kcfnen1916/wearable_tegaki/case/BASE_revised.stl

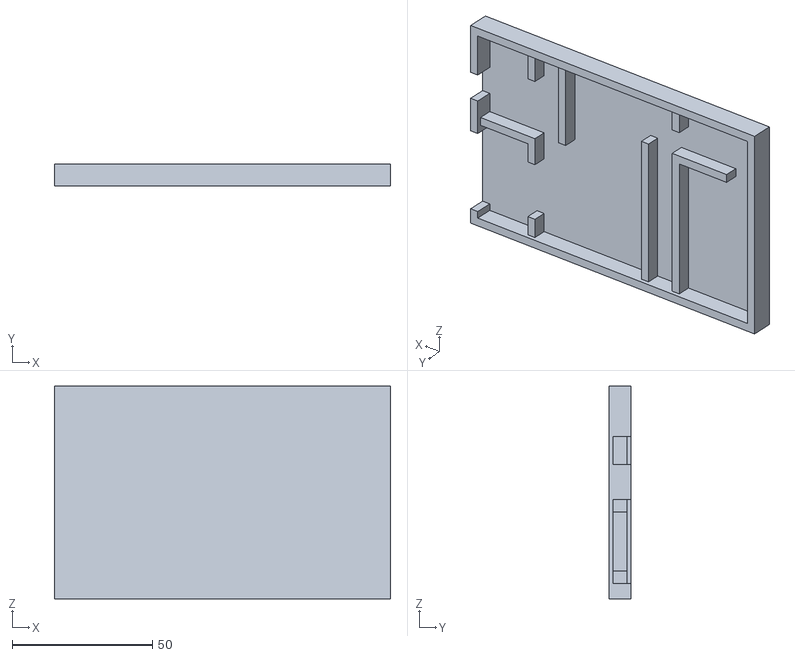
[picture p1: CAD file, 2019-09-17]
case/BASE_revised.stl
120.0 x 8.00 x 76.0
