kcfnen1916/wearable_tegaki/case/COVER_revised.stl

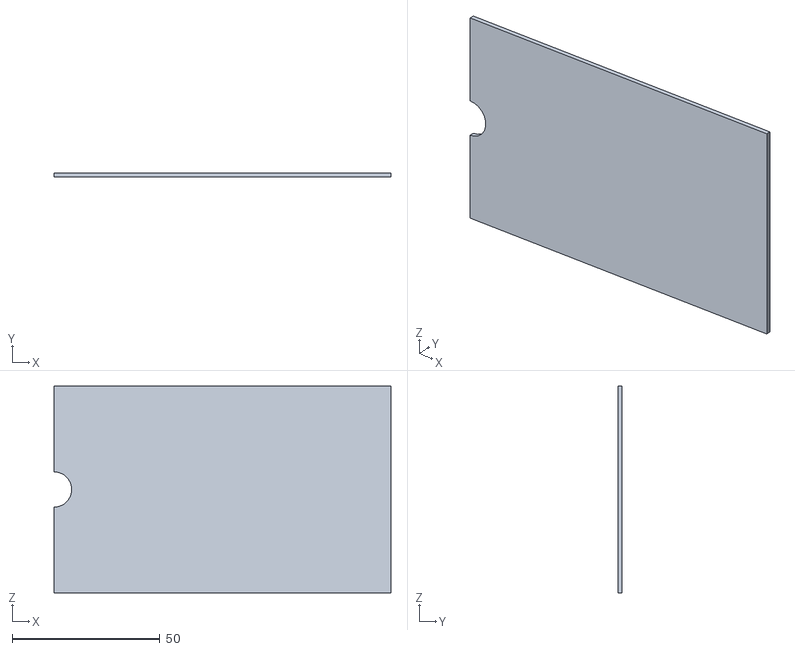
[picture p3: CAD file, 2019-09-17]
case/COVER_revised.stl
114.0 x 1.50 x 70.0
