kcfnen1916/wearable_tegaki/(list of files, cad)

Other CAD files:
case/BASE_revised.ipt
case/BASE_revised_UPBOX.ipt
case/COVER_revised.ipt
