kcfnen1916/wearable_tegaki/board/RN42.brd

## EAGLE design board/RN42.brd (2019-09-17)

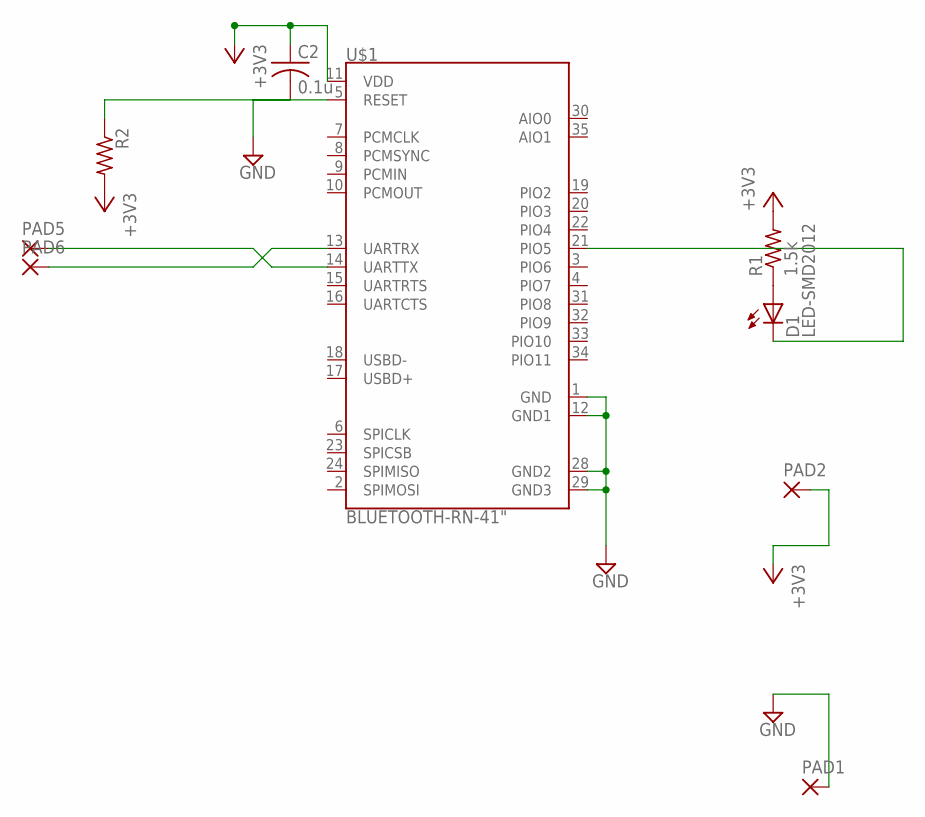
[picture p4: schematic RN42.sch]

Parts:
C2: 0.1u; 2012-C
D1: LED-SMD2012; D2012
PAD1, PAD2, PAD5, PAD6: SMD5; SMD2,54-5,08
R1: 1.5k; 2012-R
R2: 10k; 2012-R
U$1: BLUETOOTH-RN-41"; RN41

Connections:
+3V3: C2.1, PAD2.1, R1.2, R2.2, U$1.11 (VDD)
GND: C2.2, PAD1.1, U$1.1 (GND), U$1.12 (GND1), U$1.28 (GND2), U$1.29 (GND3)
unnamed: D1.K, U$1.21 (PIO5)
unnamed: D1.A, R1.1
unnamed: PAD5.1, U$1.14 (UARTTX)
unnamed: R2.1, U$1.5 (RESET)
unnamed: PAD6.1, U$1.13 (UARTRX)

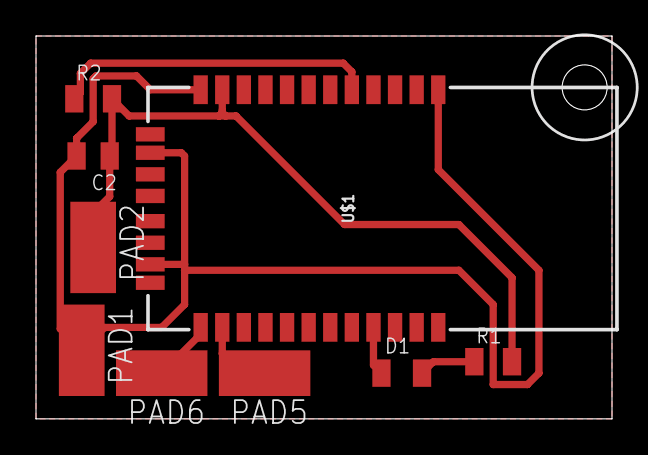
[picture p5: board RN42.brd from above]

Board: 2 copper layers, 32.0 x 21.3 mm, 10 parts (0 on the bottom side), 7 nets.

Other parts of the board:
U$2: DRIL-2,5
