kcfnen1916/wearable_tegaki/mozc-nazoru/board/nazoru-stack.brd

## EAGLE design mozc-nazoru/board/nazoru-stack.brd (2019-08-06)

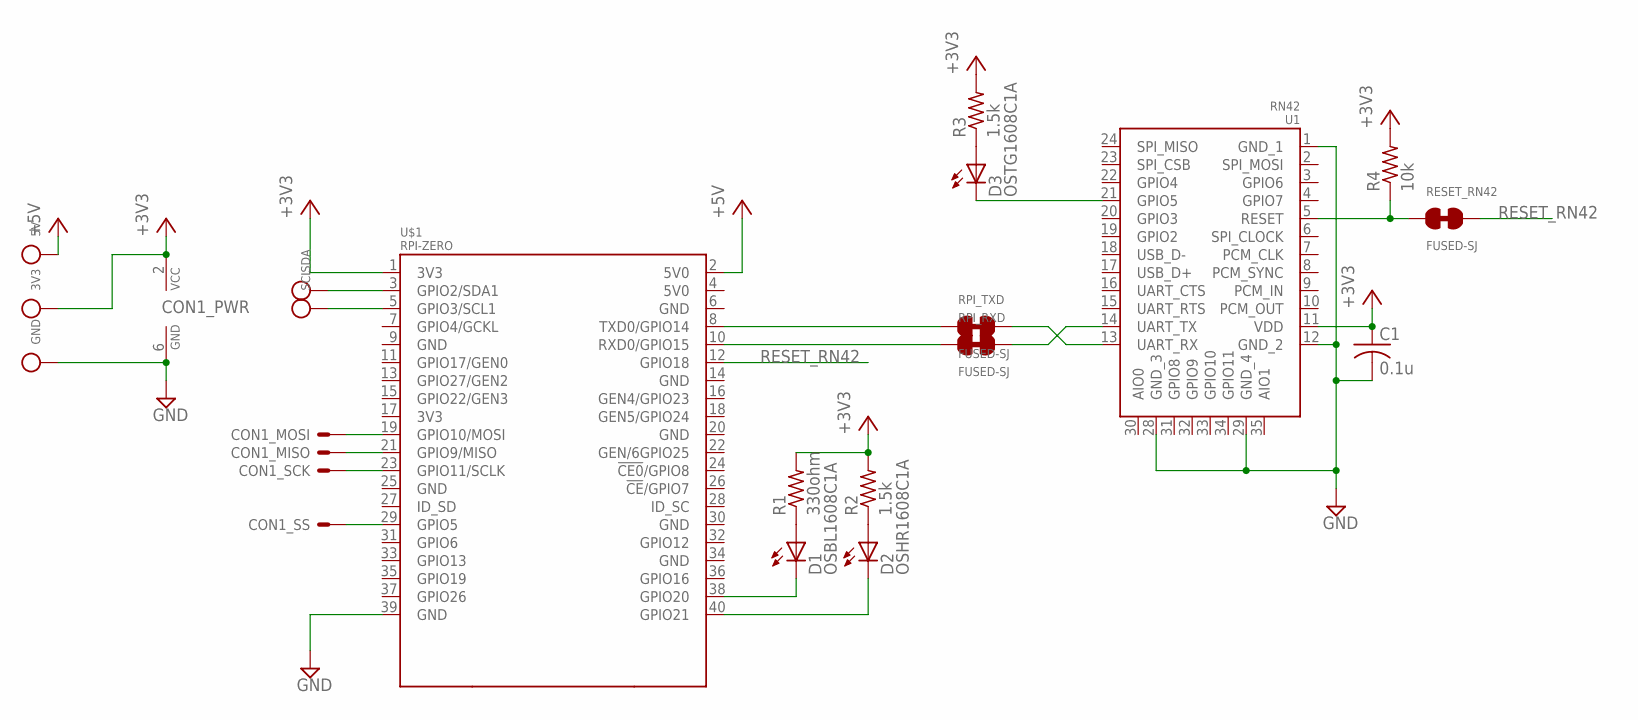
[picture p6: schematic nazoru-stack.sch]

Parts:
3V3, 5V: CHECK_PIN; SLC-22-G
C1: 0.1u; 2012-C
CON1: SPI; ML6
D1: OSBL1608C1A; 1608-LED
D2: OSHR1608C1A; 1608-LED
D3: OSTG1608C1A; 1608-LED
GND: CHECK_PIN; SLC-22-G
R1: 330ohm; 1608
R2, R3: 1.5k; 1608
R4: 10k; 1608
RESET_RN42: FUSED-SJ
RPI_RXD: FUSED-SJ
RPI_TXD: FUSED-SJ
SCL: CHECK_PIN; SLC-22-G
SDA: CHECK_PIN; SLC-22-G
U1: RN42
U$1: RPI-ZERO

Connections:
+3V3: 3V3.SIGNAL, C1.1, CON1.2 (VCC), R1.2, R2.2, R3.2, R4.2, U1.11 (VDD), U$1.1 (3V3)
+5V: 5V.SIGNAL, U$1.2 (5V0)
GND: C1.2, CON1.6 (GND), GND.SIGNAL, U1.1 (GND_1), U1.12 (GND_2), U1.28 (GND_3), U1.29 (GND_4), U$1.39 (GND)
unnamed: D1.1 (A), R1.1
unnamed: RPI_TXD.1, U$1.8 (TXD0/GPIO14)
unnamed: RPI_RXD.1, U$1.10 (RXD0/GPIO15)
unnamed: RPI_TXD.2, U1.13 (UART_RX)
unnamed: RPI_RXD.2, U1.14 (UART_TX)
unnamed: D1.2 (K), U$1.38 (GPIO20)
unnamed: D2.2 (K), U$1.40 (GPIO21)
unnamed: D2.1 (A), R2.1
unnamed: D3.1 (A), R3.1
unnamed: D3.2 (K), U1.21 (GPIO5)
unnamed: R4.1, RESET_RN42.1, U1.5 (RESET)
unnamed: CON1.4 (S), U$1.19 (GPIO10/MOSI)
unnamed: CON1.1 (S), U$1.21 (GPIO9/MISO)
unnamed: CON1.3 (S), U$1.23 (GPIO11/SCLK)
unnamed: CON1.5 (S), U$1.29 (GPIO5)
unnamed: SDA.SIGNAL, U$1.3 (GPIO2/SDA1)
unnamed: SCL.SIGNAL, U$1.5 (GPIO3/SCL1)
RESET_RN42: RESET_RN42.2, U$1.12 (GPIO18)

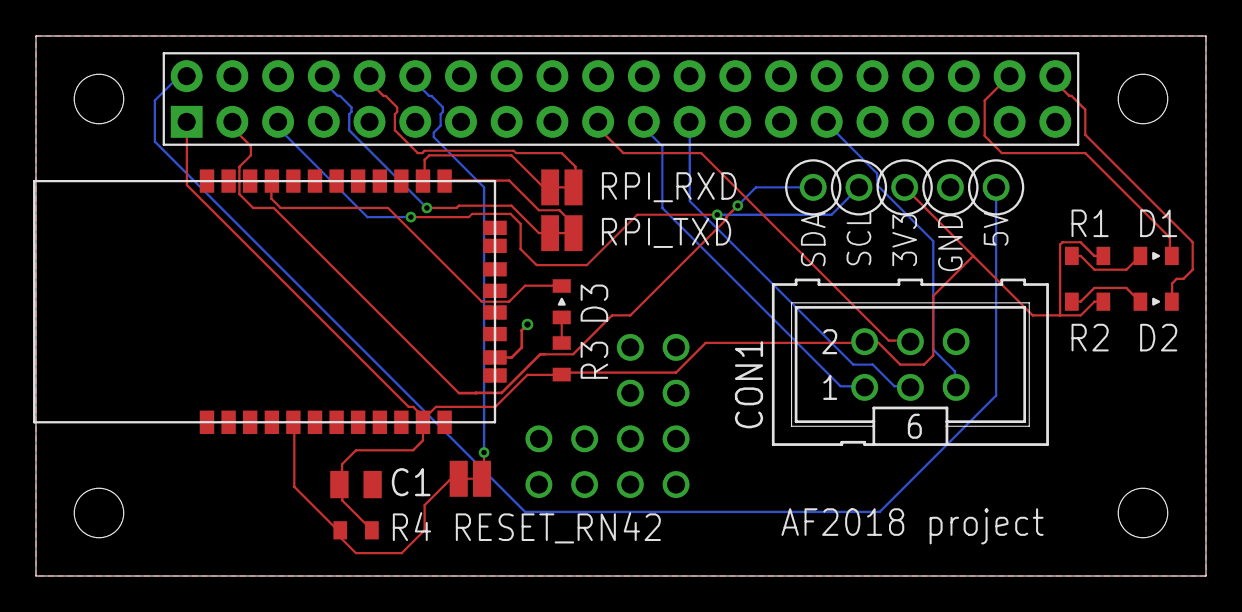
[picture p7: board nazoru-stack.brd from above]

Board: 2 copper layers, 65.0 x 30.0 mm, 19 parts (0 on the bottom side), 21 nets.
