kcfnen1916/wearable_tegaki/esp32/one_dim_hw/bluetooth.cpp

#include "bluetooth.hpp"
#include "Arduino.h"


void send_ble(String output)
{
    Serial.println(output);
    if (output == "ENTER") {
        bleKeyboard.write(KEY_RETURN);
    } else if (output == "BACKSPACE") {
        bleKeyboard.write(KEY_BACKSPACE);
    } else if (output == "LEFT") {
        bleKeyboard.write(KEY_LEFT_ARROW);
    } else if (output == "RIGHT") {
        bleKeyboard.write(KEY_RIGHT_ARROW);
    } else {
        bleKeyboard.print(output);
    }
}
