kcfnen1916/wearable_tegaki/esp32/wearbo/hand_writing.cpp

#include "hand_writing.hpp"


HandWriting::HandWriting(String output, int length, String begin, String end, String via)
{
    m_output = output;
    m_length = length;
    m_begin = begin;
    m_end = end;
    m_via = via;
}
