kcfnen1916/wearable_tegaki/(commit log)

2019-08-06 8/6 Demo時点
    [nazoru-stack.brd, nazoru-stack.sch]
2019-08-07 何も変えていません
2019-08-07 いらないファイルを削除
2019-08-08 wearable α
2019-08-09 時間のところをデバッグした(入力が早くなった)
2019-08-10 一度うまくいった
2019-08-11 学習データ生成コード
2019-08-17 フリック実装
2019-08-17 フリックバグ修正
2019-08-17 デバッグ用に修正
2019-08-18 flickできた
2019-08-18 MPR121で学習できるように変更
2019-08-20 入力ジェスチャー判定を改善
2019-08-20 学習改善
2019-08-26 flichと手書きマージ
2019-08-26 染谷研サンプルでのフリック動作を確認
2019-08-26 comment削除
2019-08-27 esp32ピン変更
2019-09-02 Bluetooth組み込み
2019-09-02 delete実装
2019-09-12 矢印キー実装
2019-09-15 コマンドライン引数に対応
2019-09-15 手書き入力でのコマンド送信
2019-09-16 大岸：CAD追加
    [BASE_revised.ipt, BASE_revised.stl, BASE_revised_UPBOX.ipt, BASE_revised_UPBOX.stl, COVER_revised.ipt, COVER_revised.stl, RN42.brd, RN42.sch]
2019-09-17 学習のために一旦coreの中のrecorderをコメントアウトしています
2019-09-17 学習した
2019-09-17 精度が上がった
2019-09-17 coreを戻した
2019-09-24 waittime平均化
2019-09-28 学習データ追加9/27
2019-09-28 core修正
2019-09-28 removeし直したデータ
2019-09-28 rだけのデータ
2019-10-08 gitignore追加
2019-10-21 c言語移行途中
2019-10-29 コンパイル通った
2019-11-06 学習データ作り
2019-11-06 とりあえず
2019-11-14 バグ修正
2019-11-15 とりあえず完成
2019-11-15 config生成
2019-11-15 ルールベースの手書き
2019-11-15 ルールベース修正
2019-11-15 ルール追加
2019-11-15 mode切替を修正
2019-11-23 配列を作れるようにした
2019-12-03 大文字以外完成
2019-12-04 M5Stick用
2019-12-06 blekeyboard修正
2019-12-06 手書きに対応
2019-12-16 コメントアウト削除
2019-12-24 GUGEN修正
2019-12-24 kとhの識別でっち上げ
2019-12-26 ルールを修正
2019-12-31 xbly微修正
2020-01-01 recordまで
2020-01-01 gch削除
2020-01-01 gitignoreにgch追加
2020-06-29 静電容量センサを認識しないバグを解消
2020-06-29 いらない行を消した
2020-06-29 少し変更
